pablogrisi/projeto_micro/Esquemático.pdf

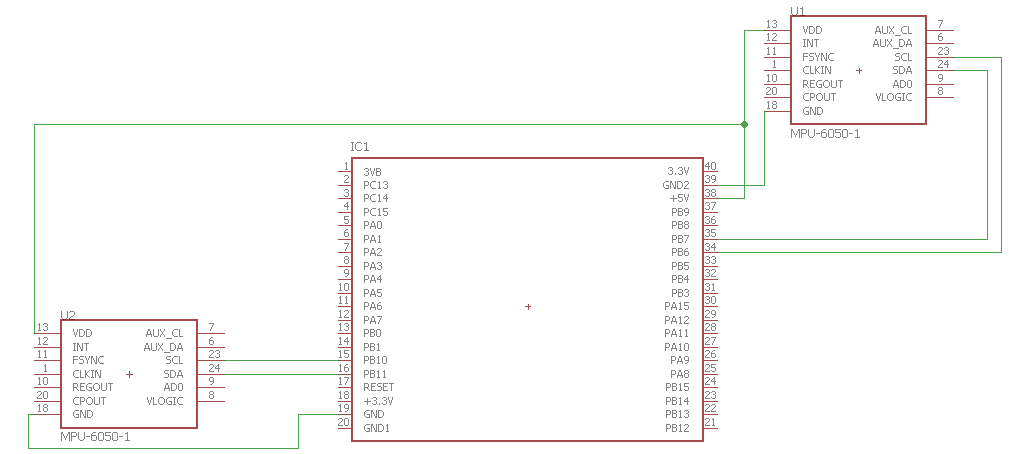
[picture p3: page 1]
