pablogrisi/projeto_micro/Pictures/1.jpg

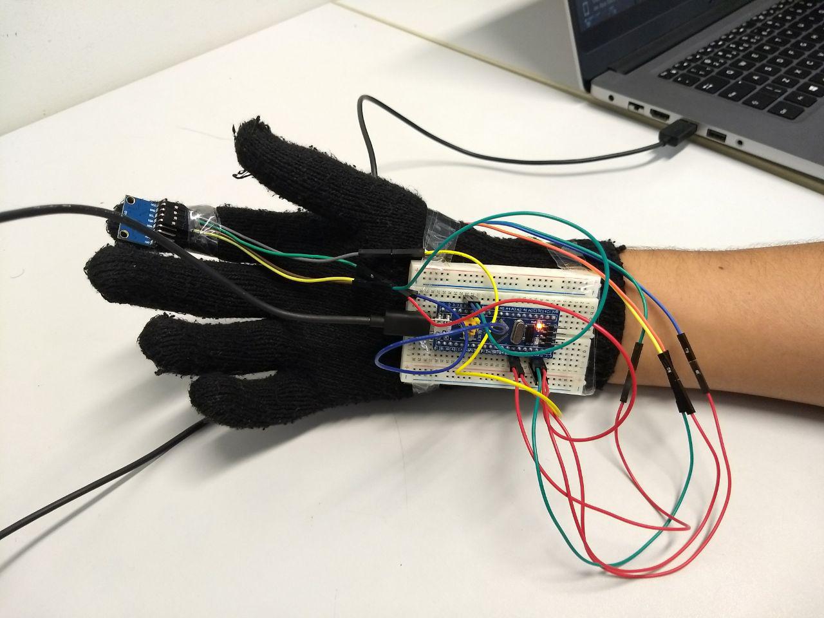
Pictures/1.jpg
