pablogrisi/projeto_micro/Esquemático.sch

## EAGLE design Esquemático.sch (2017-12-14)

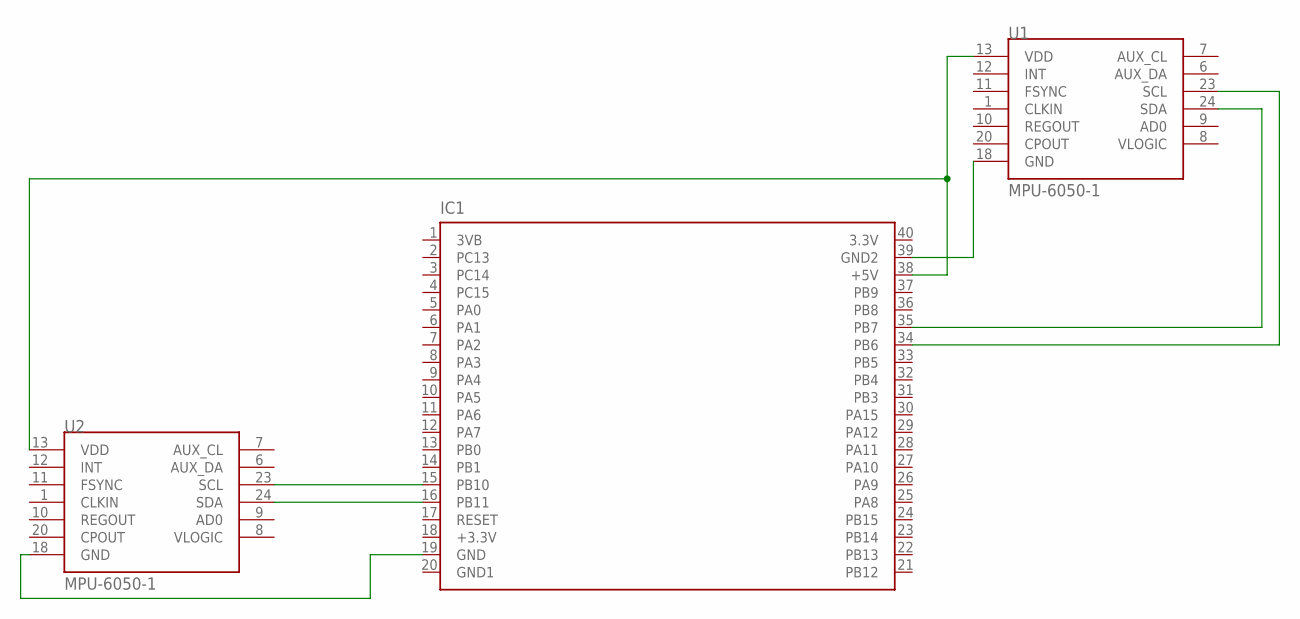
[picture p7: schematic Esquemático.sch]

Parts:
IC1: BLUEPILL550; DIL40
U1, U2: MPU-6050-1; QFN-24-4MM2

Connections:
unnamed: IC1.15 (PB10), U2.23 (SCL)
unnamed: IC1.35 (PB7), U1.24 (SDA)
unnamed: IC1.34 (PB6), U1.23 (SCL)
unnamed: IC1.16 (PB11), U2.24 (SDA)
unnamed: IC1.38 (+5V), U1.13 (VDD), U2.13 (VDD)
unnamed: IC1.39 (GND2), U1.18 (GND)
unnamed: IC1.19 (GND), U2.18 (GND)
