pablogrisi/projeto_micro/projeto_micro/Src/main.c

/**
  ******************************************************************************
  * File Name          : main.c
  * Description        : Main program body
  ******************************************************************************
  * This notice applies to any and all portions of this file
  * that are not between comment pairs USER CODE BEGIN and
  * USER CODE END. Other portions of this file, whether 
  * inserted by the user or by software development tools
  * are owned by their respective copyright owners.
  *
  * Copyright (c) 2017 STMicroelectronics International N.V. 
  * All rights reserved.
  *
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
  ******************************************************************************
  */

/* Includes ------------------------------------------------------------------*/
#include "main.h"
#include "stm32f1xx_hal.h"
#include "i2c.h"
#include "usb_device.h"
#include "gpio.h"

/* USER CODE BEGIN Includes */
#include "sd_hal_mpu6050.h"
#include "stm32f1xx.h"
#include "stm32f1xx_hal.h"
/* USER CODE END Includes */


/* USER CODE BEGIN PV */

SD_MPU6050 mpu1;
SD_MPU6050 mpu2;
/* USER CODE END PV */

void SystemClock_Config(void);

/* USER CODE BEGIN PFP */

/* USER CODE END PFP */

int main(void)
{

  /* USER CODE BEGIN 1 */
	SD_MPU6050_Result result, result2;
	uint8_t mpu_ok[15] = {"MPU WORK FINE\n"};
	uint8_t mpu_not[17] = {"MPU NOT WORKING\n"};

	//	HID MOUSE
		struct mouseHID_t {
		      uint8_t buttons;
		      int8_t x;
		      int8_t y;
		      int8_t wheel;
		  };
		  struct mouseHID_t mouseHID;
		  mouseHID.buttons = 0;
		  mouseHID.x = 10;
		  mouseHID.y = 0;
		  mouseHID.wheel = 0;


  /* USER CODE END 1 */

  /* MCU Configuration----------------------------------------------------------*/

  /* Reset of all peripherals, Initializes the Flash interface and the Systick. */
  HAL_Init();

  /* Configure the system clock */
  SystemClock_Config();

  /* Initialize all configured peripherals */
  MX_GPIO_Init();
  MX_I2C1_Init();
  MX_USB_DEVICE_Init();
  MX_I2C2_Init();

  /* USER CODE BEGIN 2 */
  int16_t aux = 0;
  int16_t auy = 0;

//  int16_t g_x = 0;
//  int16_t g_y = 0;

  /* USER CODE END 2 */

  /* Infinite loop */
  /* USER CODE BEGIN WHILE */
  while (1)
  {
	  result = SD_MPU6050_Init(&hi2c1,&mpu1,SD_MPU6050_Device_0,SD_MPU6050_Accelerometer_2G,SD_MPU6050_Gyroscope_250s );
	  result2 = SD_MPU6050_Init(&hi2c2,&mpu2,SD_MPU6050_Device_0,SD_MPU6050_Accelerometer_2G,SD_MPU6050_Gyroscope_250s );

	  HAL_Delay(25);
  /* USER CODE END WHILE */

  /* USER CODE BEGIN 3 */

//	  Reading Mouse Position
	  SD_MPU6050_ReadGyroscope(&hi2c1, &mpu1);

	  int16_t g_x = mpu1.Gyroscope_X;
	  int16_t g_y = mpu1.Gyroscope_Y;
	  int16_t g_z = mpu1.Gyroscope_Z;

//	  Coordenada Y
	  if((g_x - aux) > 300 && -(g_x - aux) < -300){
		  mouseHID.y = (g_x)/150;
	  } else {
		  if(g_x < 0 && (g_x - aux) < -300){
	  		  mouseHID.y = (g_x)/150;
	  	  } else {
	  		  mouseHID.y = 0;
	  	  }
	  }

//	  Coordenada X
	  if((g_y - auy) > 300 && -(g_y - auy) < -300){
		  mouseHID.x = (g_y)/150;
	  } else {
		  if(g_y < 0 && (g_y - auy) < -300){
			  mouseHID.x = (g_y)/150;
		  } else {
			  mouseHID.x = 0;
		  }
	  }

//	  Reading Button Accelerometer
	  SD_MPU6050_ReadAccelerometer(&hi2c2, &mpu2);
	  int16_t a_x = mpu2.Accelerometer_X;

//	  Button Clicked
	  if(a_x < -4500){
	  	  mouseHID.buttons = 1;
	  	  mouseHID.x = 0;
	  	  mouseHID.y = 0;
		  USBD_HID_SendReport(&hUsbDeviceFS, &mouseHID, sizeof(struct mouseHID_t));
	  }
	  HAL_Delay(25);

//	  Button Released
	  if(a_x > -4500)
	  {
		  mouseHID.buttons = 0;
	  }
	  USBD_HID_SendReport(&hUsbDeviceFS, &mouseHID, sizeof(struct mouseHID_t));
	  HAL_Delay(5);
  }
  /* USER CODE END 3 */

}

/** System Clock Configuration
*/
void SystemClock_Config(void)
{

  RCC_OscInitTypeDef RCC_OscInitStruct;
  RCC_ClkInitTypeDef RCC_ClkInitStruct;
  RCC_PeriphCLKInitTypeDef PeriphClkInit;

    /**Initializes the CPU, AHB and APB busses clocks 
    */
  RCC_OscInitStruct.OscillatorType = RCC_OSCILLATORTYPE_HSE;
  RCC_OscInitStruct.HSEState = RCC_HSE_ON;
  RCC_OscInitStruct.HSEPredivValue = RCC_HSE_PREDIV_DIV1;
  RCC_OscInitStruct.HSIState = RCC_HSI_ON;
  RCC_OscInitStruct.PLL.PLLState = RCC_PLL_ON;
  RCC_OscInitStruct.PLL.PLLSource = RCC_PLLSOURCE_HSE;
  RCC_OscInitStruct.PLL.PLLMUL = RCC_PLL_MUL6;
  if (HAL_RCC_OscConfig(&RCC_OscInitStruct) != HAL_OK)
  {
    _Error_Handler(__FILE__, __LINE__);
  }

    /**Initializes the CPU, AHB and APB busses clocks 
    */
  RCC_ClkInitStruct.ClockType = RCC_CLOCKTYPE_HCLK|RCC_CLOCKTYPE_SYSCLK
                              |RCC_CLOCKTYPE_PCLK1|RCC_CLOCKTYPE_PCLK2;
  RCC_ClkInitStruct.SYSCLKSource = RCC_SYSCLKSOURCE_PLLCLK;
  RCC_ClkInitStruct.AHBCLKDivider = RCC_SYSCLK_DIV1;
  RCC_ClkInitStruct.APB1CLKDivider = RCC_HCLK_DIV2;
  RCC_ClkInitStruct.APB2CLKDivider = RCC_HCLK_DIV1;

  if (HAL_RCC_ClockConfig(&RCC_ClkInitStruct, FLASH_LATENCY_1) != HAL_OK)
  {
    _Error_Handler(__FILE__, __LINE__);
  }

  PeriphClkInit.PeriphClockSelection = RCC_PERIPHCLK_USB;
  PeriphClkInit.UsbClockSelection = RCC_USBCLKSOURCE_PLL;
  if (HAL_RCCEx_PeriphCLKConfig(&PeriphClkInit) != HAL_OK)
  {
    _Error_Handler(__FILE__, __LINE__);
  }

  HAL_RCC_MCOConfig(RCC_MCO, RCC_MCO1SOURCE_SYSCLK, RCC_MCODIV_1);

    /**Configure the Systick interrupt time 
    */
  HAL_SYSTICK_Config(HAL_RCC_GetHCLKFreq()/1000);

    /**Configure the Systick 
    */
  HAL_SYSTICK_CLKSourceConfig(SYSTICK_CLKSOURCE_HCLK);

  /* SysTick_IRQn interrupt configuration */
  HAL_NVIC_SetPriority(SysTick_IRQn, 0, 0);
}

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
