pablogrisi/projeto_micro/(commit log)

2017-10-28 Esquemático
    [Esquemático.sch]
2017-11-22 Esquemático
    Agora usando comunicação I2C
    [Esquemático.sch]
2017-11-23 Mouse movimenta-se somente com a bluepill
    Com este código é possível movimentar o cursor utilizando apenas a bluepill, próximo passo será adicionar os acelerômetros para detectar a movimentação da luva.
2017-12-01 Biblioteca Externa
    External library containing all the functions used. I am only uploading this, in case we need to copy the files again, but they are already inside the folders (inc2 and src2).
2017-12-14 Documento de Instruções
2017-12-14 Deletar pasta antiga para upar o código final
    Qualquer problema, há um backup.
    [main.c]
2017-12-14 Última versão do Esquemático
    Presentes tanto:
    Esquemático.pdf
    Esquemático.png
    Esquemático.sch
    [Esquemático.sch]
2017-12-15 Adicionando versão final do projeto
    A versão anterior foi apagada, subi a versão que estava no meu pc, dos códigos mais recentes, que fizemos até o dia 14/12.
2017-12-15 Adicionando arquivos que ficaram faltando
