pablogrisi/projeto_micro/(notices)

Notices in the files:
projeto_micro/Src/main.c:
(C) COPYRIGHT STMicroelectronics *****END OF FILE
